ibm2030/IOSelectric/README.md

IOSelectric
===========

Arduino based serial interface for an IBM I/O Selectric typewriter/printer
