ibm2030/IOSelectric/Hardware/Selectric_BOT.PNG

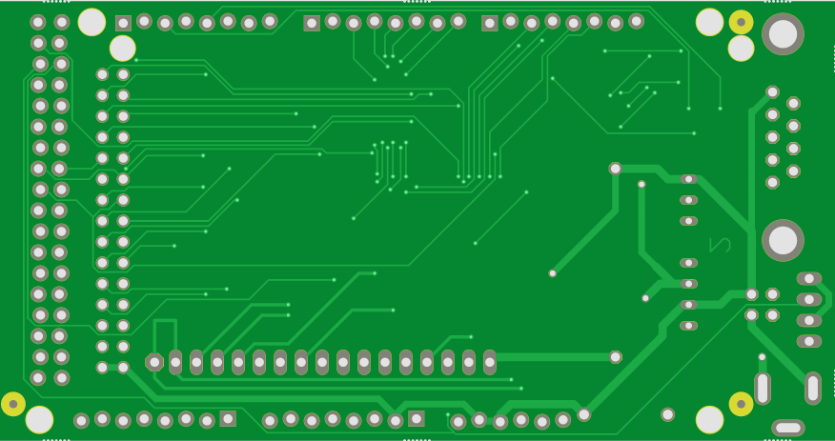
Hardware/Selectric_BOT.PNG
