ibm2030/IOSelectric/Hardware/Selectric_TOP.PNG

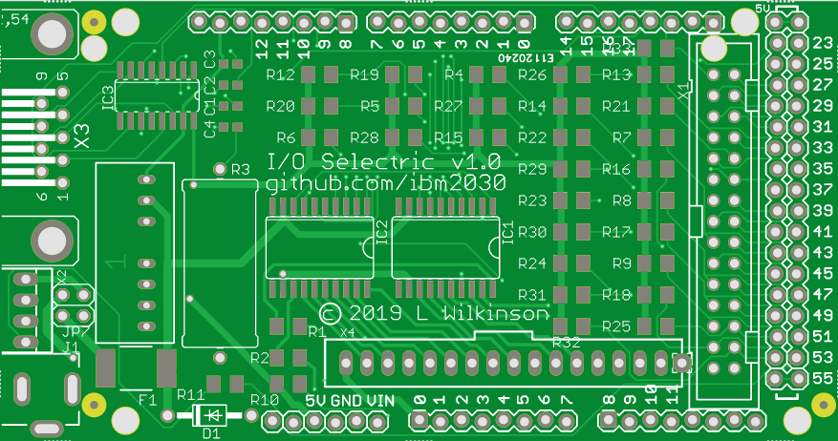
Hardware/Selectric_TOP.PNG
