ibm2030/IOSelectric/Hardware/SelectricBRD-BOT.pdf

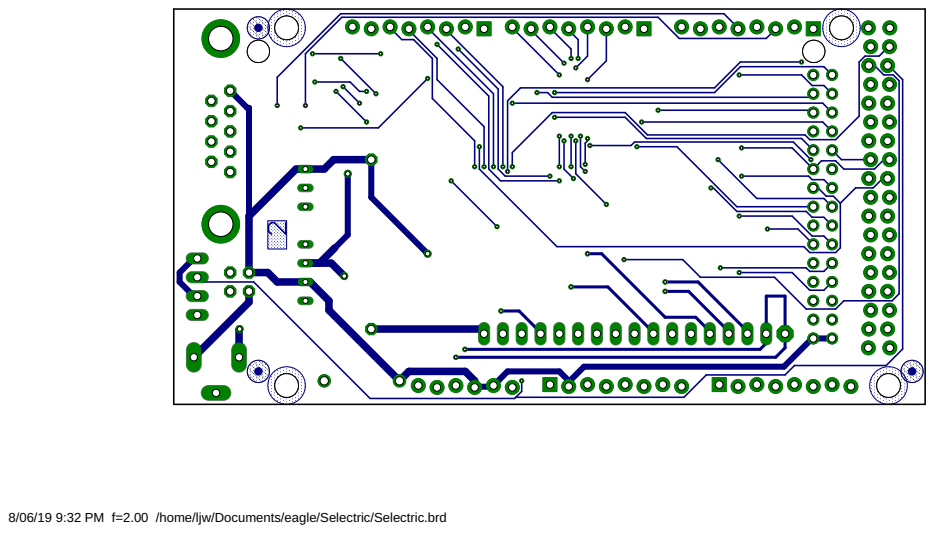
[picture p3: page 1]

8/06/19 9:32 PM f=2.00 /home/ljw/Documents/eagle/Selectric/Selectric.brd
