ibm2030/IOSelectric/Hardware/SelectricBRD-TOP.pdf

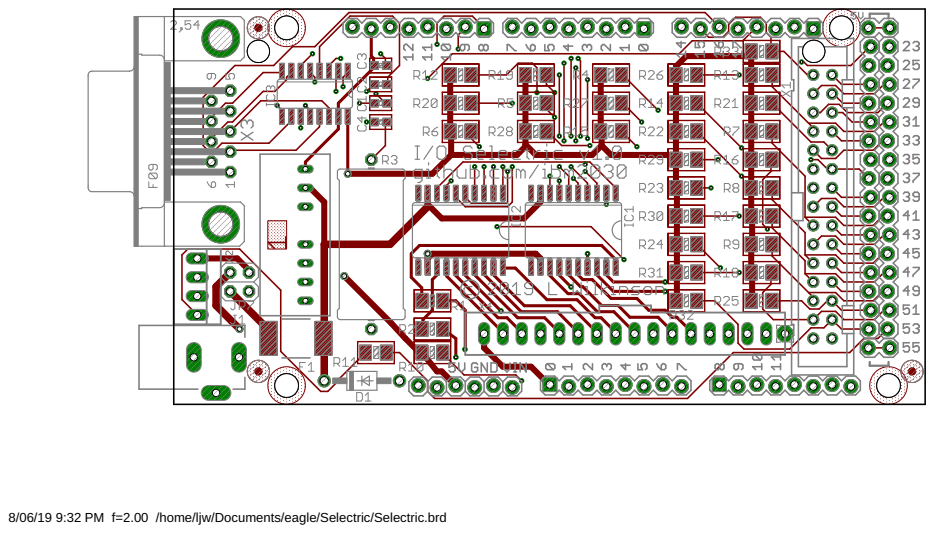
[picture p4: page 1]

8/06/19 9:32 PM f=2.00 /home/ljw/Documents/eagle/Selectric/Selectric.brd
