ibm2030/IOSelectric/Hardware/SelectricSCH.pdf

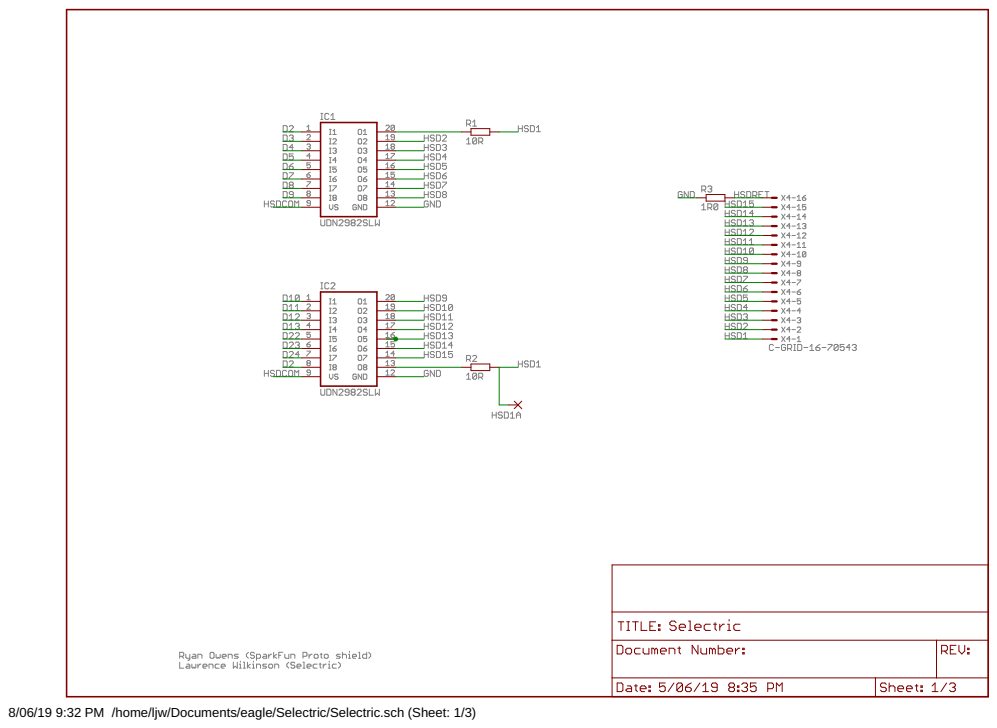
[picture p5: page 1]

8/06/19 9:32 PM /home/ljw/Documents/eagle/Selectric/Selectric.sch (Sheet: 1/3)

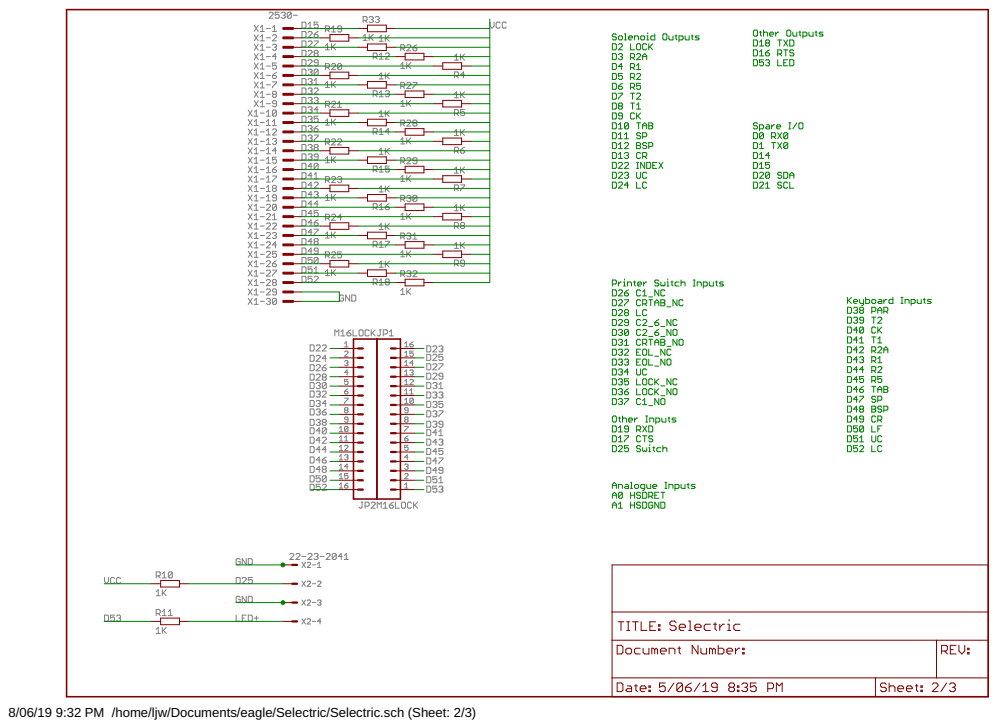
[picture p6: page 2]

8/06/19 9:32 PM /home/ljw/Documents/eagle/Selectric/Selectric.sch (Sheet: 2/3)

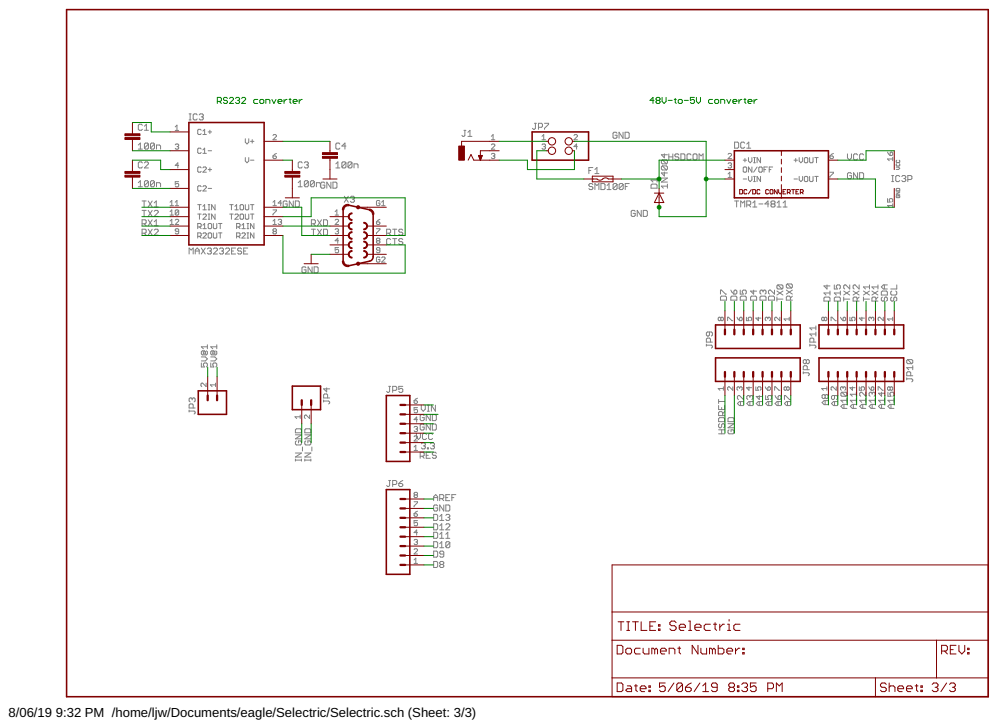
[picture p7: page 3]

8/06/19 9:32 PM /home/ljw/Documents/eagle/Selectric/Selectric.sch (Sheet: 3/3)
