ibm2030/IOSelectric/Hardware/Selectric.brd

## EAGLE design Hardware/Selectric.brd (2019-06-08)

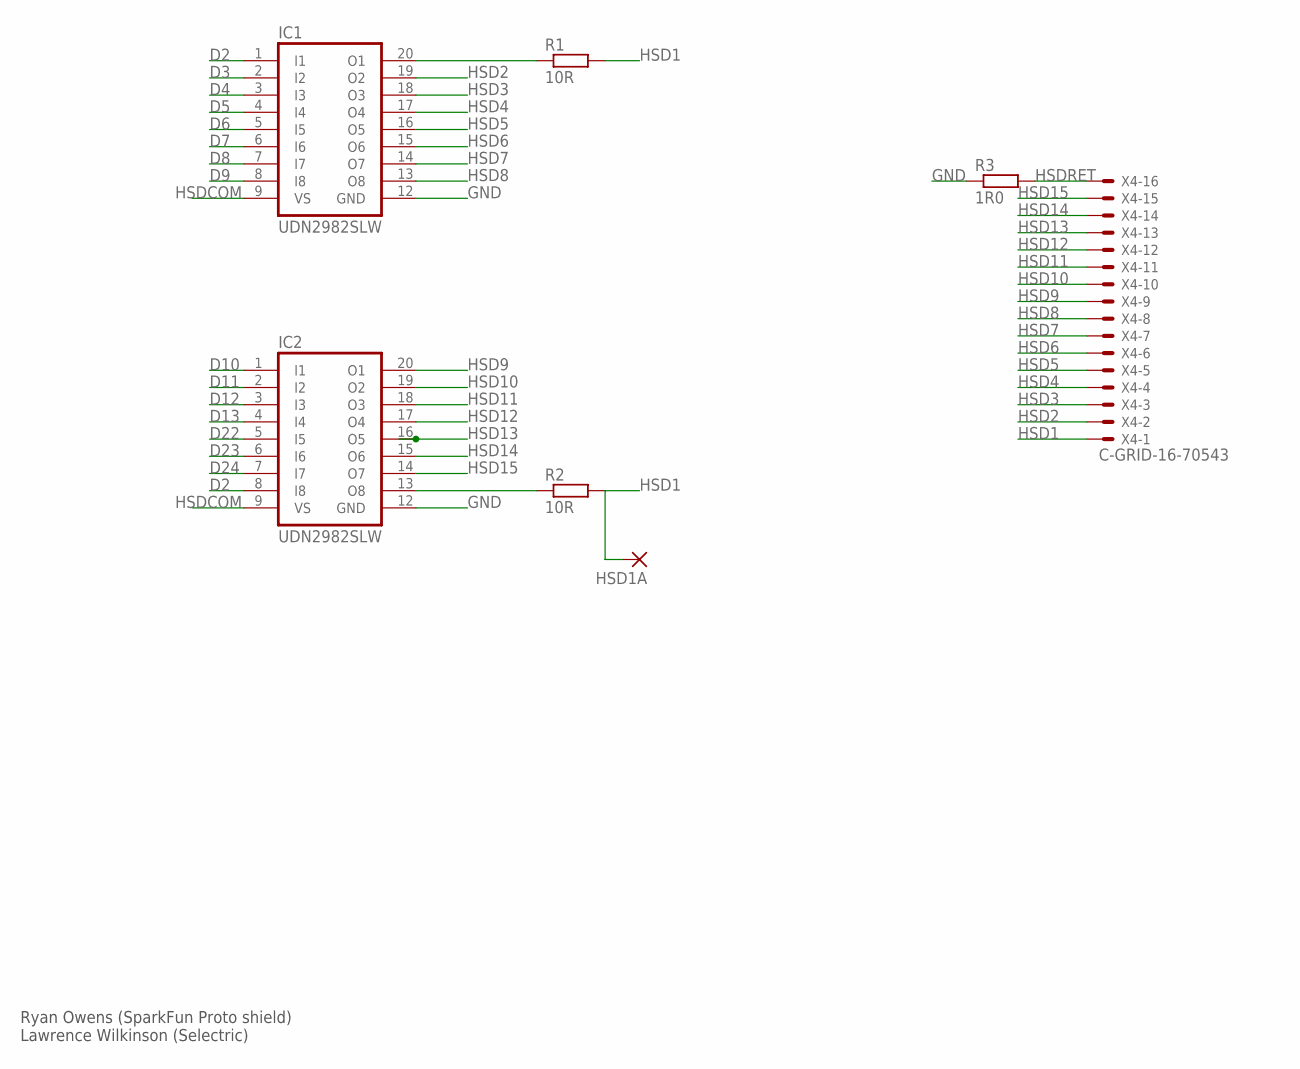
[picture p8: schematic Selectric.sch, sheet 1]

Parts:
HSD1A: 2,15/1,0
IC1, IC2: UDN2982SLW; SO20W; MPN UDN2982SLW
R1, R2: 10R; M1206
R3: 1R0; 0922/22
X4: C-GRID-16-70543; 70543-16

Connections:
D2: IC1.1 (I1), IC2.8 (I8); also elsewhere on the board
D3: IC1.2 (I2); also elsewhere on the board
D4: IC1.3 (I3); also elsewhere on the board
D5: IC1.4 (I4); also elsewhere on the board
D6: IC1.5 (I5); also elsewhere on the board
D7: IC1.6 (I6); also elsewhere on the board
D8: IC1.7 (I7); also elsewhere on the board
D9: IC1.8 (I8); also elsewhere on the board
D10: IC2.1 (I1); also elsewhere on the board
D11: IC2.2 (I2); also elsewhere on the board
D12: IC2.3 (I3); also elsewhere on the board
D13: IC2.4 (I4); also elsewhere on the board
D22: IC2.5 (I5); also elsewhere on the board
D23: IC2.6 (I6); also elsewhere on the board
D24: IC2.7 (I7); also elsewhere on the board
GND: IC1.12 (GND), IC2.12 (GND), R3.1; also elsewhere on the board
HSD1: HSD1A.1, R1.2, R2.2, X4.1
HSD1A: IC2.13 (O8), R2.1
HSD2: IC1.19 (O2), X4.2
HSD3: IC1.18 (O3), X4.3
HSD4: IC1.17 (O4), X4.4
HSD5: IC1.16 (O5), X4.5
HSD6: IC1.15 (O6), X4.6
HSD7: IC1.14 (O7), X4.7
HSD8: IC1.13 (O8), X4.8
HSD9: IC2.20 (O1), X4.9
HSD10: IC2.19 (O2), X4.10
HSD11: IC2.18 (O3), X4.11
HSD12: IC2.17 (O4), X4.12
HSD13: IC2.16 (O5), X4.13
HSD14: IC2.15 (O6), X4.14
HSD15: IC2.14 (O7), X4.15
HSDCOM: IC1.9 (VS), IC2.9 (VS); also elsewhere on the board
HSDRET: R3.2, X4.16; also elsewhere on the board
unnamed: IC1.20 (O1), R1.1

Notes on the sheet:
Ryan Owens (SparkFun Proto shield) Lawrence Wilkinson (Selectric)

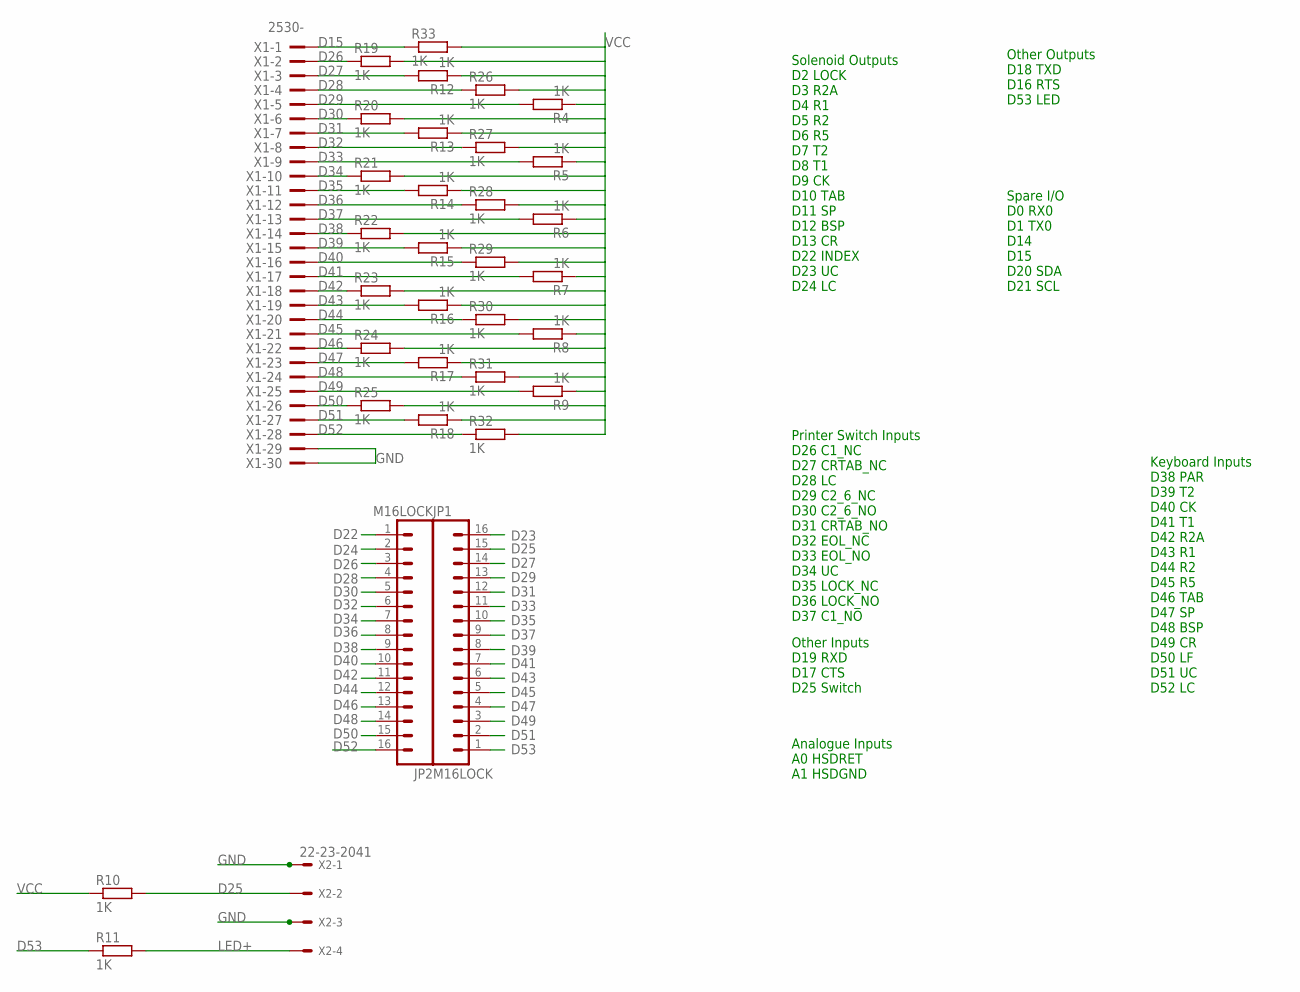
[picture p9: schematic Selectric.sch, sheet 2]

Parts:
JP1, JP2: M16LOCK; 1X16_LOCK; MPN 61301611121
R4, R5, R6, R7, R8, R9, R10, R11, R12, R13, R14, R15, R16, R17, R18, R19, R20, R21, R22, R23, R24, R25, R26, R27, R28, R29, R30, R31, R32, R33: 1K; M1206
X1: 2530-; PAK100/2500-30; MPN PAK100/2500-30
X2: 22-23-2041; MPN 280371-2

Connections:
D15: R33.1, X1.1; also elsewhere on the board
D22: JP2.1; also elsewhere on the board
D23: JP1.16; also elsewhere on the board
D24: JP2.2; also elsewhere on the board
D25: JP1.15, R10.2, X2.2
D26: JP2.3, R19.1, X1.2
D27: JP1.14, R12.2, X1.3
D28: JP2.4, R26.1, X1.4
D29: JP1.13, R4.2, X1.5
D30: JP2.5, R20.1, X1.6
D31: JP1.12, R13.2, X1.7
D32: JP2.6, R27.1, X1.8
D33: JP1.11, R5.2, X1.9
D34: JP2.7, R21.1, X1.10
D35: JP1.10, R14.2, X1.11
D36: JP2.8, R28.1, X1.12
D37: JP1.9, R6.2, X1.13
D38: JP2.9, R22.1, X1.14
D39: JP1.8, R15.2, X1.15
D40: JP2.10, R29.1, X1.16
D41: JP1.7, R7.2, X1.17
D42: JP2.11, R23.1, X1.18
D43: JP1.6, R16.2, X1.19
D44: JP2.12, R30.1, X1.20
D45: JP1.5, R8.2, X1.21
D46: JP2.13, R24.1, X1.22
D47: JP1.4, R17.2, X1.23
D48: JP2.14, R31.1, X1.24
D49: JP1.3, R9.2, X1.25
D50: JP2.15, R25.1, X1.26
D51: JP1.2, R18.2, X1.27
D52: JP2.16, R32.1, X1.28
D53: JP1.1, R11.1
GND: X1.29, X1.30, X2.1, X2.3; also elsewhere on the board
LED+: R11.2, X2.4
VCC: R4.1, R5.1, R6.1, R7.1, R8.1, R9.1, R10.1, R12.1, R13.1, R14.1, R15.1, R16.1, R17.1, R18.1, R19.2, R20.2, R21.2, R22.2, R23.2, R24.2, R25.2, R26.2, R27.2, R28.2, R29.2, R30.2, R31.2, R32.2, R33.2; also elsewhere on the board

Notes on the sheet:
Solenoid Outputs D2 LOCK D3 R2A D4 R1 D5 R2 D6 R5 D7 T2 D8 T1 D9 CK D10 TAB D11 SP D12 BSP D13 CR D22 INDEX D23 UC D24 LC
Other Outputs D18 TXD D16 RTS D53 LED
Printer Switch Inputs D26 C1_NC D27 CRTAB_NC D28 LC D29 C2_6_NC D30 C2_6_NO D31 CRTAB_NO D32 EOL_NC D33 EOL_NO D34 UC D35 LOCK_NC D36 LOCK_NO D37 C1_NO
Keyboard Inputs D38 PAR D39 T2 D40 CK D41 T1 D42 R2A D43 R1 D44 R2 D45 R5 D46 TAB D47 SP D48 BSP D49 CR D50 LF D51 UC D52 LC
Other Inputs D19 RXD D17 CTS D25 Switch
Analogue Inputs A0 HSDRET A1 HSDGND
Spare I/O D0 RX0 D1 TX0 D14 D15 D20 SDA D21 SCL

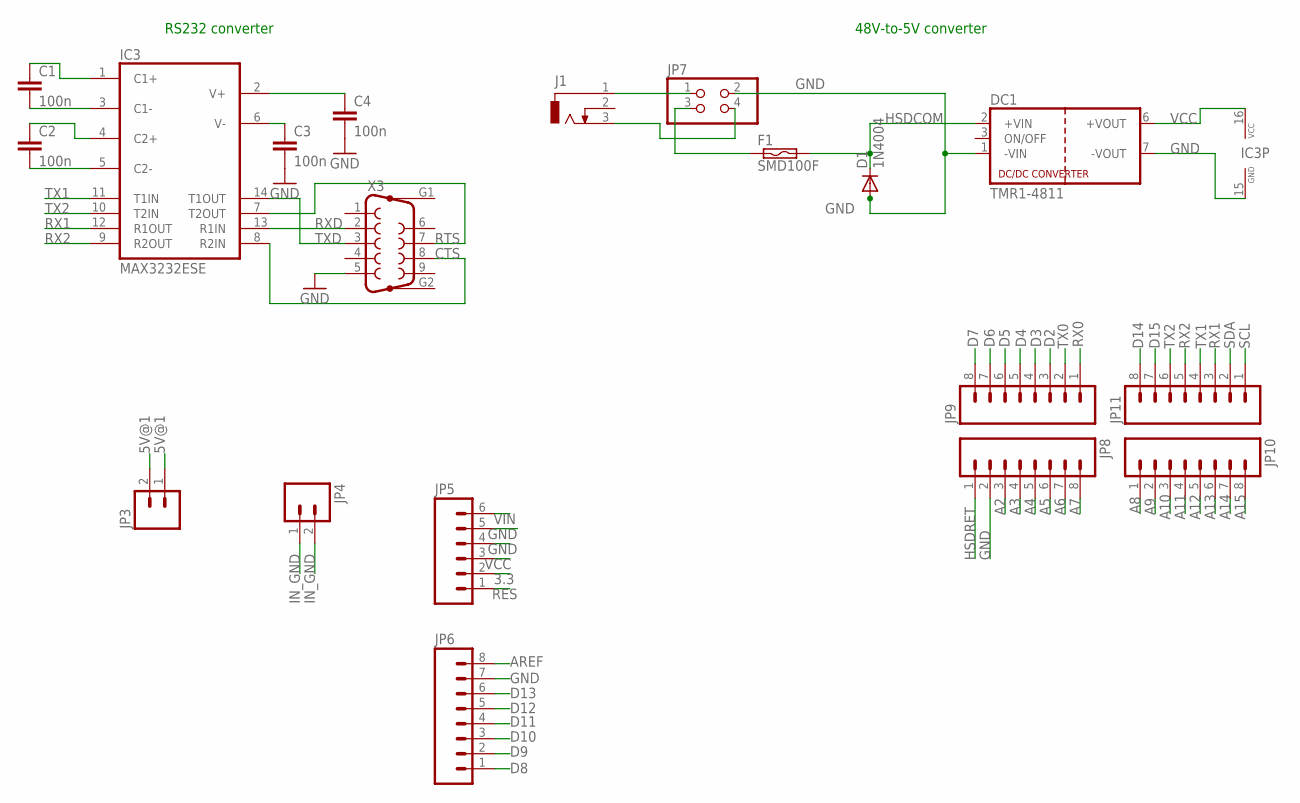
[picture p10: schematic Selectric.sch, sheet 3]

Parts:
C1, C2, C3, C4: 100n; C0603
D1: 1N4004; DO41-10
DC1: TMR1-4811; TRACO_SIP-8; MPN TMR1-4811
F1: SMD100F; SMD050F; MPN 3404.0009.11
IC3: MAX3232ESE; SO16; MPN MAX3232CSE
J1: DCJ0303
JP3, JP4: M02LOCK; 1X02_LOCK
JP5: M06LOCK; 1X06_LOCK; MPN 826629-6
JP6, JP8, JP9, JP10, JP11: M08LOCK; 1X08_LOCK; MPN 826629-8
JP7: PINHD-2X2; 2X02; MPN 826632-2
X3: F09HP; MPN FCE17-E09PA-490

Connections:
3.3: JP5.2
5V@1: JP3.1, JP3.2
A2: JP8.3
A3: JP8.4
A4: JP8.5
A5: JP8.6
A6: JP8.7
A7: JP8.8
A8: JP10.1
A9: JP10.2
A10: JP10.3
A11: JP10.4
A12: JP10.5
A13: JP10.6
A14: JP10.7
A15: JP10.8
AREF: JP6.8
CTS: IC3.8 (R2IN), X3.8
D2: JP9.3; also elsewhere on the board
D3: JP9.4; also elsewhere on the board
D4: JP9.5; also elsewhere on the board
D5: JP9.6; also elsewhere on the board
D6: JP9.7; also elsewhere on the board
D7: JP9.8; also elsewhere on the board
D8: JP6.1; also elsewhere on the board
D9: JP6.2; also elsewhere on the board
D10: JP6.3; also elsewhere on the board
D11: JP6.4; also elsewhere on the board
D12: JP6.5; also elsewhere on the board
D13: JP6.6; also elsewhere on the board
D14: JP11.8
D15: JP11.7; also elsewhere on the board
GND: C3.2, C4.2, D1.A, DC1.1 (-VIN), DC1.7 (-VOUT), IC3.15 (GND), JP5.4, JP5.5, JP6.7, JP7.2, JP8.2, X3.5; also elsewhere on the board
HSDCOM: D1.C, DC1.2 (+VIN), F1.2; also elsewhere on the board
HSDRET: JP8.1; also elsewhere on the board
IN_GND: JP4.1, JP4.2
unnamed: C1.1, IC3.1 (C1+)
unnamed: C2.1, IC3.4 (C2+)
unnamed: C1.2, IC3.3 (C1-)
unnamed: C2.2, IC3.5 (C2-)
unnamed: C4.1, IC3.2 (V+)
unnamed: C3.1, IC3.6 (V-)
unnamed: J1.3, JP7.4
unnamed: J1.1, JP7.1
unnamed: F1.1, JP7.3
RES: JP5.1
RTS: IC3.7 (T2OUT), X3.7
RX0: JP9.1
RX1: IC3.12 (R1OUT), JP11.3
RX2: IC3.9 (R2OUT), JP11.5
RXD: IC3.13 (R1IN), X3.2
SCL: JP11.1
SDA: JP11.2
TX0: JP9.2
TX1: IC3.11 (T1IN), JP11.4
TX2: IC3.10 (T2IN), JP11.6
TXD: IC3.14 (T1OUT), X3.3
VCC: DC1.6 (+VOUT), IC3.16 (VCC), JP5.3; also elsewhere on the board
VIN: JP5.6

Notes on the sheet:
48V-to-5V converter
RS232 converter

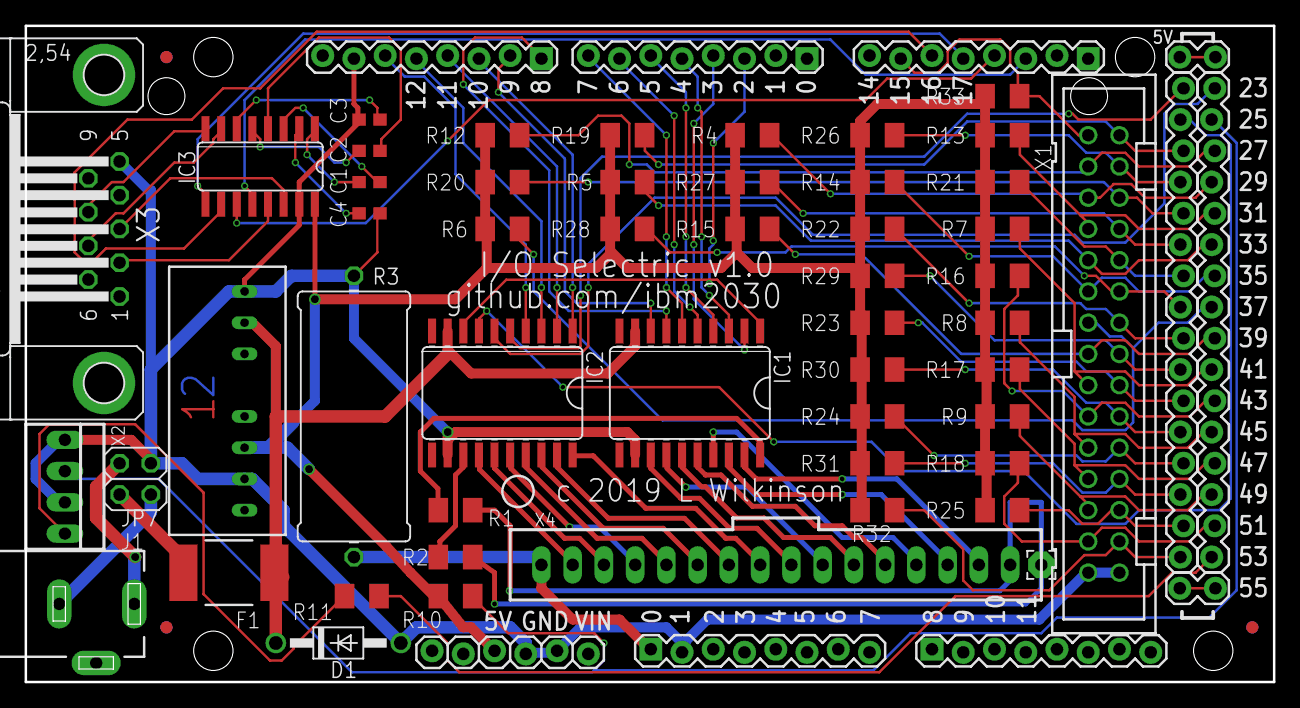
[picture p11: board Selectric.brd from above]

Board: 2 copper layers, 101.5 x 53.3 mm, 63 parts (0 on the bottom side), 86 nets.

Other parts of the board:
U$1, U$2, U$3: CIRCLE-1MM-3R
