ibm2030/IOSelectric/(commit log)

2013-03-16 Initial version of Arduino program
2013-03-19 V1.1 Re-work to remove String objects Add Min/Max times to statistics Remove superfluous debugging printlns Fix various timeouts and stat calcs Add check for previous cycle complete at start of print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
    [IOSelectric.ino]
2013-03-23 V1.2 Tidy up timeouts Fix up correspondence coding table Add cycle time stats Add XON/XOFF and CTS/RTS handshaking
    [IOSelectric.ino]
2013-07-10 Tidy up timeouts for real Selectric Select appropriate options for use with S/360 emulator Prevent CR from terminating too early Fix bug in CR stats, add CONTACT_ definitions Allow correct keyboard o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
    [IOSelectric.ino]
2013-07-10 IBM 360 assembler program to demonstrate I/O Selectric operation The program waits for a line to be typed, the prints a prompt Four lines of up to 20 characters can be typed, which will then be print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
2014-02-01 Add temporary pdf schematic of Arduino interface
2019-04-29 Add files via upload
    Initial 2-layer version, not checked.
    DRU file is eC_2Layer_PClass6_BaseCopperO18_eCDefault.dru from https://www.eurocircuits.com/EAGLE-DRU-files-for-the-Eurocircuits-pooling-services/
    [Selectric.brd, Selectric.sch]
2019-05-08 Updated schematic and tidied board
    Added Arduino 5V power feed. Tidied some traces and labels.
    [Selectric.brd, Selectric.sch]
2019-05-12 Adjust some screen labels for tidiness
    [Selectric.brd]
2019-05-14 Modify to use Allegro A2982SLW-T drivers
    Replace discrete mosfets with A2982 driver ICs.
    [Selectric.brd, Selectric.sch]
2019-05-14 Images of PCB
2019-05-26 Add switch/LED header J2
    [Selectric.brd, Selectric.sch]
2019-05-27 Finalise components and values. add BoM
    [Selectric.brd, Selectric.sch]
2019-06-02 Modify connectors, assign I/Os
    Add eC-stencil registration holes
    [Selectric.brd, Selectric.sch]
2019-06-02 Board images for latest update
2019-06-08 Version as ordered
    Note BoM is not necessarily accurate
    [Selectric.brd, Selectric.sch]
2019-06-08 Assign Input and Output numbers to match PCB
    Note PCB has two drivers for the LOCK output driven from the D2 output. These can be separated at the power side by cutting a trace but will still be driven from D2 unless further modifications are made.
2025-12-16 Fix critical logic error in shift checking
    Fixed bug in printCharacter() where the shift check condition used OR (||)
    instead of AND (&&), causing it to always evaluate to true. This resulted in
    unnecessary shift operations even for characters like "." and "," that exist
    on both shift levels.
    Changed line 740 from:
    if ((code!=0x1a)|| (code!=0x29))
    To:
    if ((code!=0x1a) && (code!=0x29))
    Also added BUGS_FOUND.md documenting this fix and 4 other bugs discovered
    in the codebase that should be addressed in future updates.
